MehmetEralpKose/Ripple-Warriors-Hardware-Project-/3phase_diode+buck/Test Results/R load/optocoupler voltage.jpeg

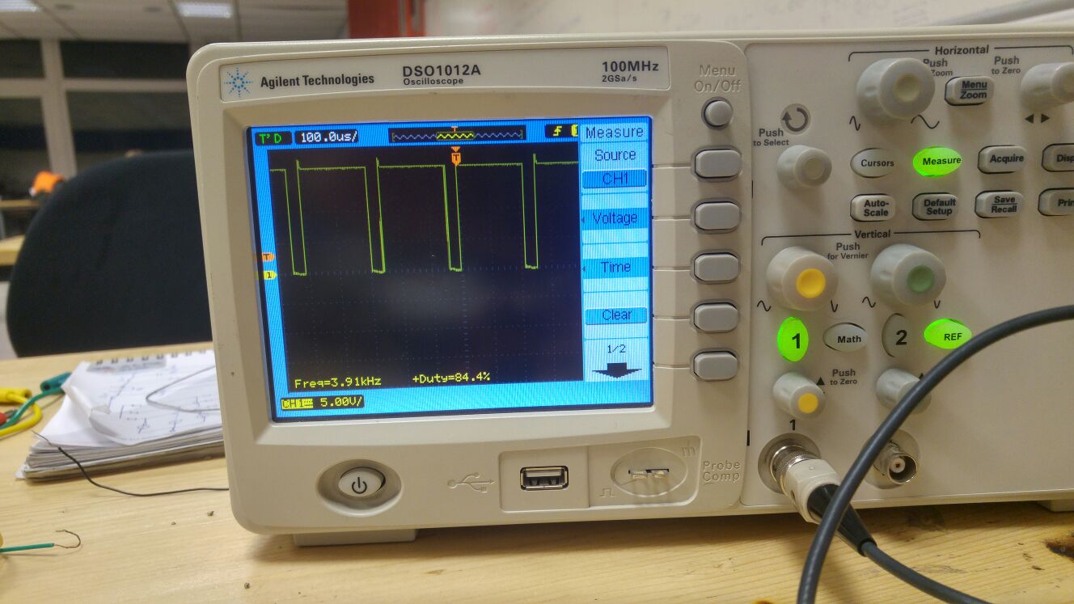
3phase_diode+buck/Test Results/R load/optocoupler voltage.jpeg
