MehmetEralpKose/Ripple-Warriors-Hardware-Project-/3phase_diode+buck/Test Results/Motor/Output current and voltage for motor load.jpeg

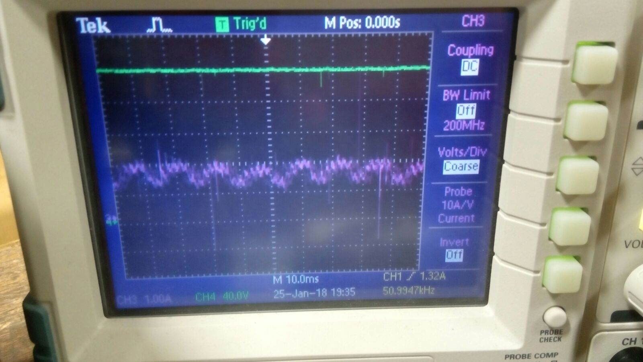
3phase_diode+buck/Test Results/Motor/Output current and voltage for motor load.jpeg
