MehmetEralpKose/Ripple-Warriors-Hardware-Project-/README.md

# Ripple-Warriors-Hardware-Project-

This repository presents Hardware Project of EE463 Static Power Conversion-I. 
Team Members:
[Raşit Gökmen](https://github.com/rasitgokmen)
[Mehmet Eralp Köse](https://github.com/MehmetEralpKose)
[Mahmut Enes Kara](https://github.com/mahmuteneskara)
