MehmetEralpKose/Ripple-Warriors-Hardware-Project-/3phase_diode+buck/overall schematic.png

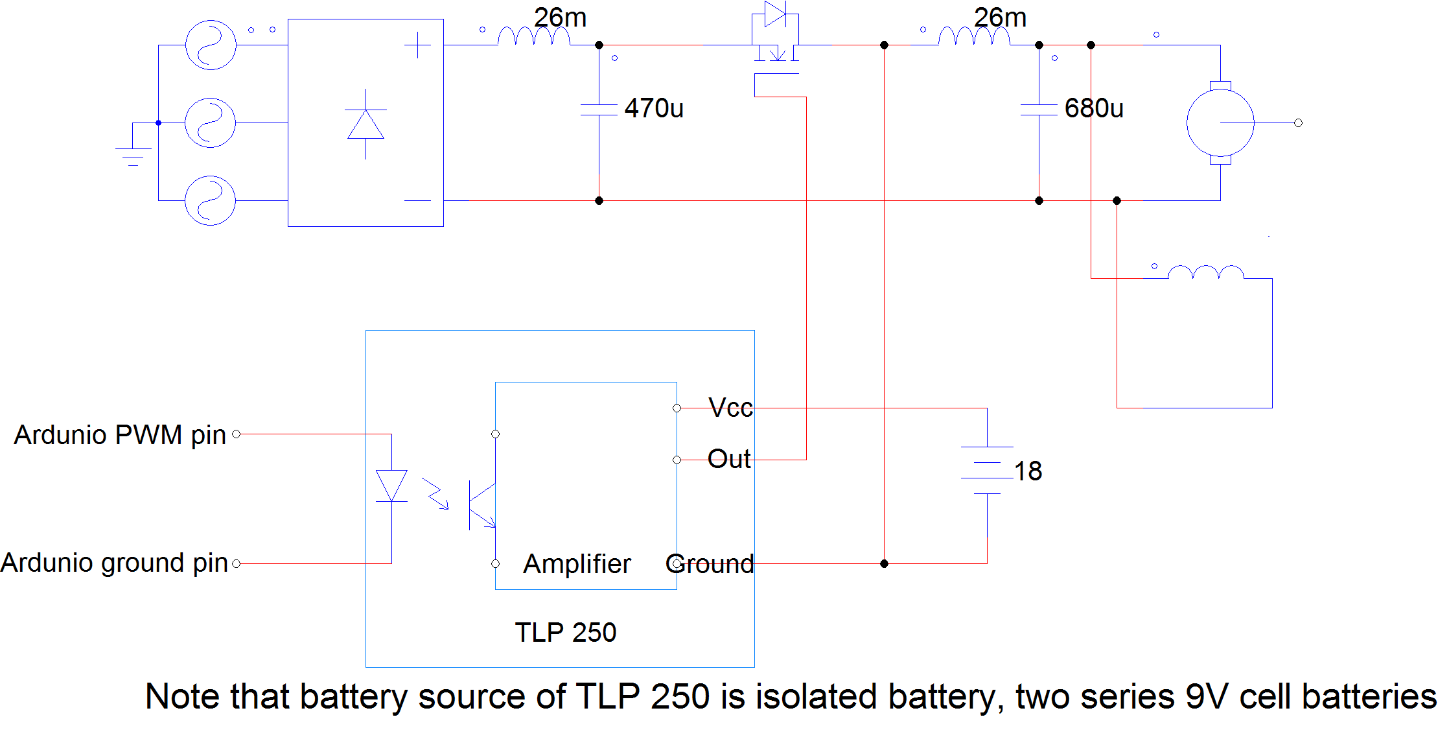
3phase_diode+buck/overall schematic.png
