MehmetEralpKose/Ripple-Warriors-Hardware-Project-/Researches/Block_Diagram of Hardware Project.PNG

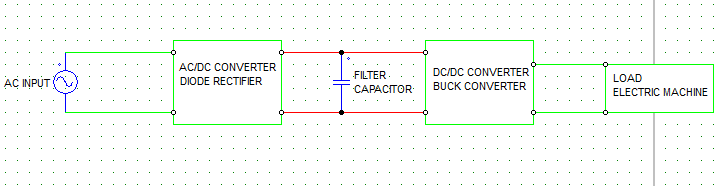
Researches/Block_Diagram of Hardware Project.PNG
