MehmetEralpKose/Ripple-Warriors-Hardware-Project-/Researches/Circuit_Schematic.JPG

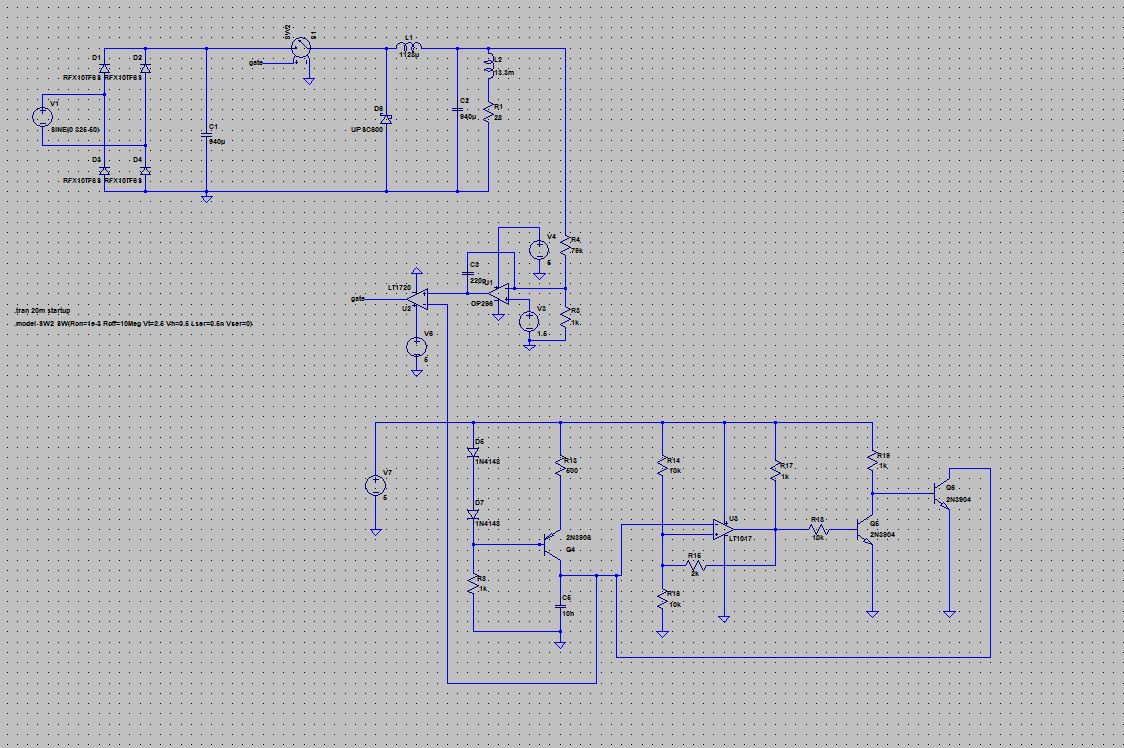
Researches/Circuit_Schematic.JPG
