MehmetEralpKose/Ripple-Warriors-Hardware-Project-/Researches/Rectifier_outputcurrent and voltage.PNG

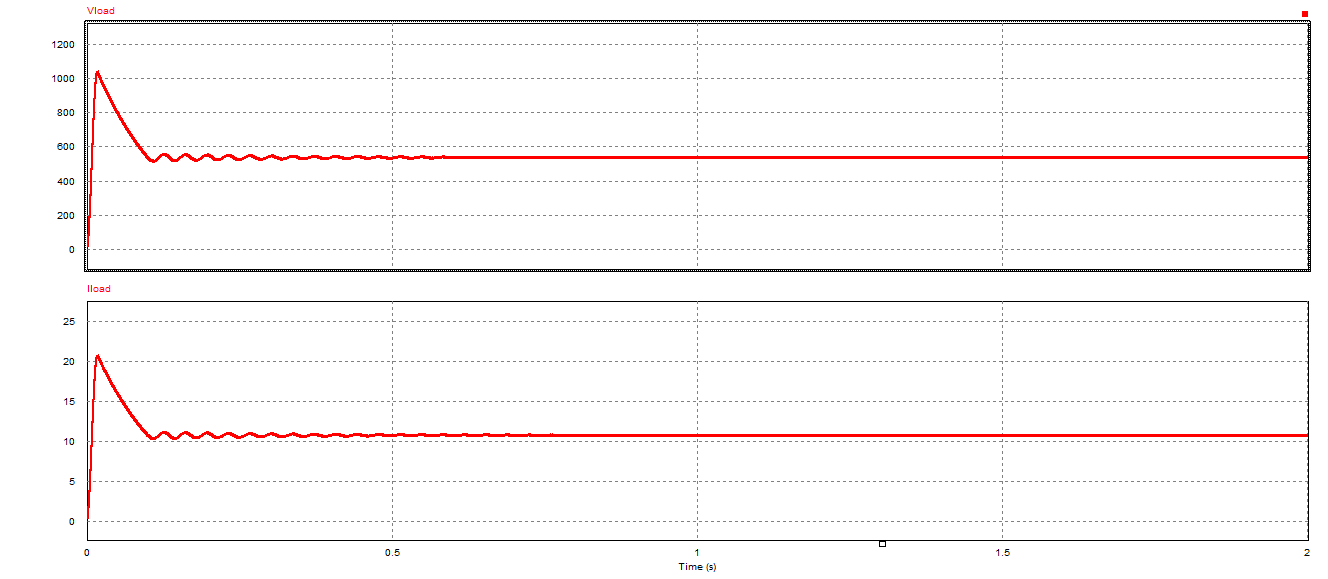
Researches/Rectifier_outputcurrent and voltage.PNG
