MehmetEralpKose/Ripple-Warriors-Hardware-Project-/Researches/Vout.png

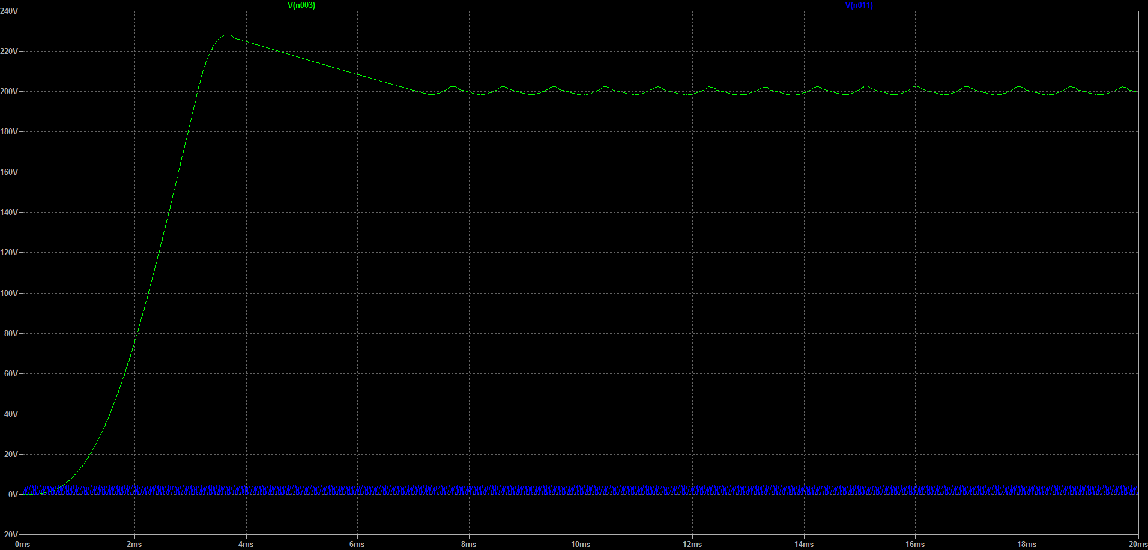
Researches/Vout.png
