MehmetEralpKose/Ripple-Warriors-Hardware-Project-/3phase_diode+buck/Test Results/Motor/Inductor voltage for motor.jpeg

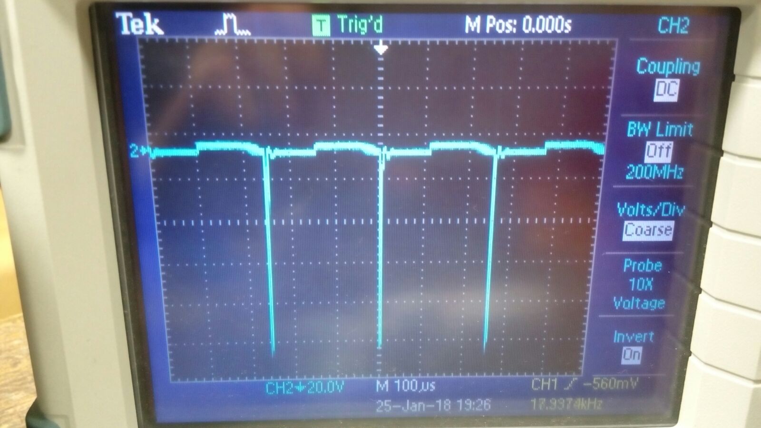
3phase_diode+buck/Test Results/Motor/Inductor voltage for motor.jpeg
