MehmetEralpKose/Ripple-Warriors-Hardware-Project-/3phase_diode+buck/Test Results/Motor/Input current for motor.jpeg

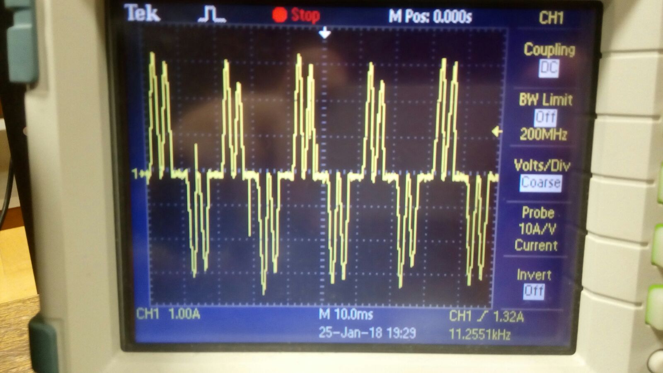
3phase_diode+buck/Test Results/Motor/Input current for motor.jpeg
