MehmetEralpKose/Ripple-Warriors-Hardware-Project-/3phase_diode+buck/Test Results/Motor/Output current for motor.jpeg

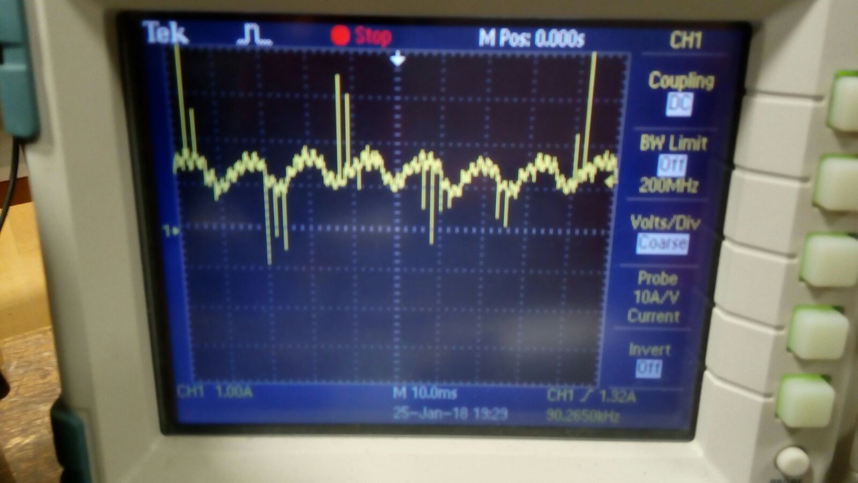
3phase_diode+buck/Test Results/Motor/Output current for motor.jpeg
