MehmetEralpKose/Ripple-Warriors-Hardware-Project-/3phase_diode+buck/Test Results/Motor/Output power.jpeg

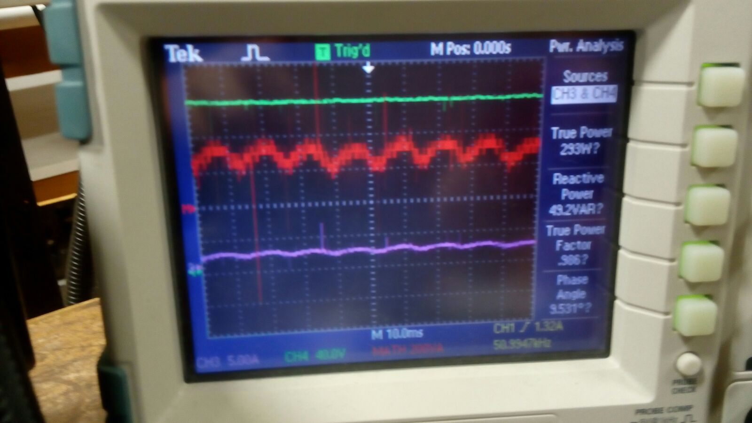
3phase_diode+buck/Test Results/Motor/Output power.jpeg
