MehmetEralpKose/Ripple-Warriors-Hardware-Project-/3phase_diode+buck/Test Results/Motor/Output voltage and PWM for motor.jpeg

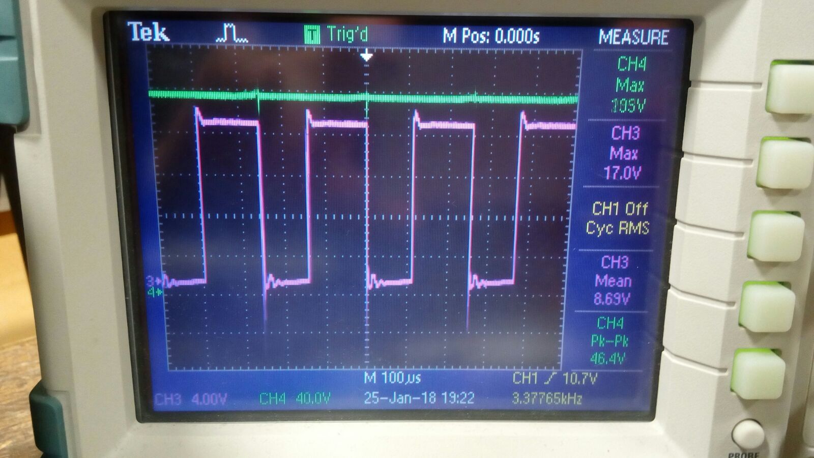
3phase_diode+buck/Test Results/Motor/Output voltage and PWM for motor.jpeg
