MehmetEralpKose/Ripple-Warriors-Hardware-Project-/3phase_diode+buck/Test Results/Motor/Temperature of the power MOSFET under load after 5 minutes.jpeg

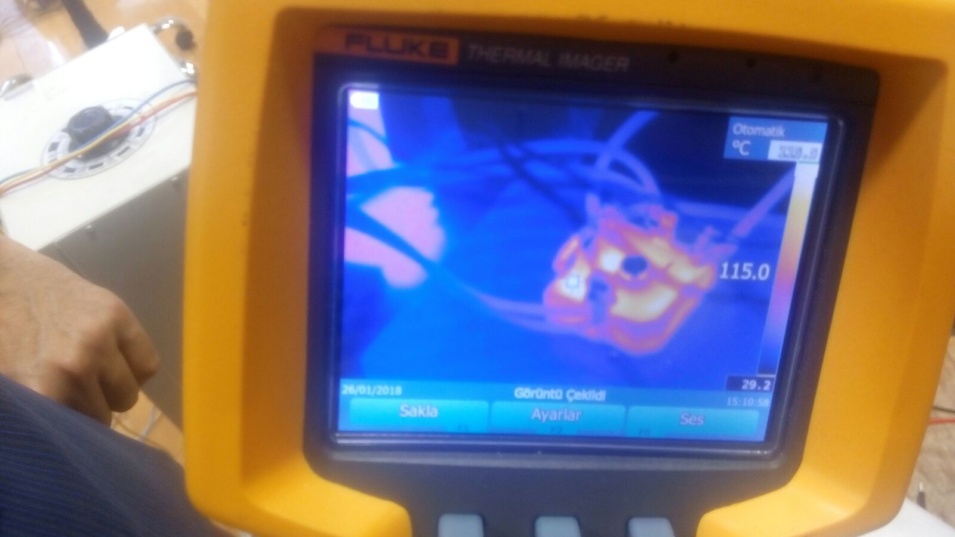
3phase_diode+buck/Test Results/Motor/Temperature of the power MOSFET under load after 5 minutes.jpeg
