MehmetEralpKose/Ripple-Warriors-Hardware-Project-/3phase_diode+buck/Test Results/R load/Duty cycle and output current- voltages for R load .jpeg

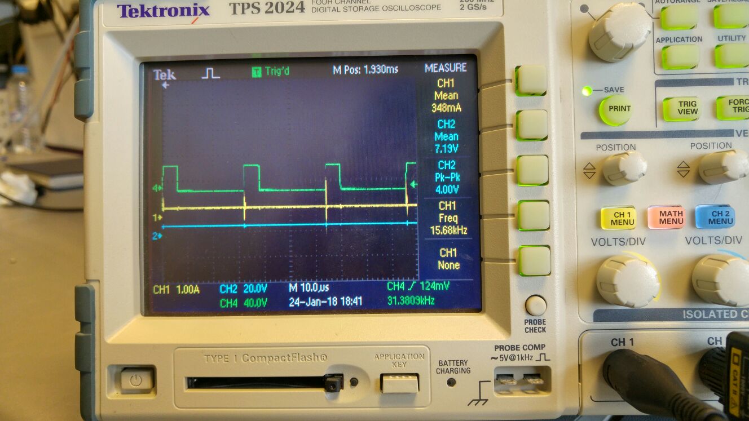
3phase_diode+buck/Test Results/R load/Duty cycle and output current- voltages for R load .jpeg
