MehmetEralpKose/Ripple-Warriors-Hardware-Project-/3phase_diode+buck/Test Results/R load/Inductor voltage for 4kHz.jpeg

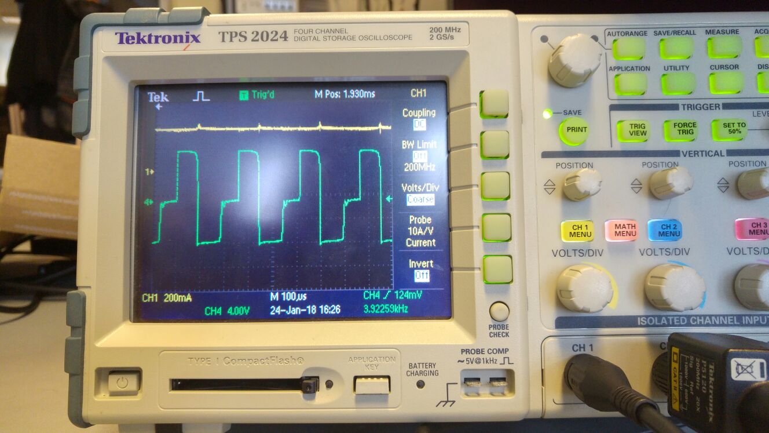
3phase_diode+buck/Test Results/R load/Inductor voltage for 4kHz.jpeg
