MehmetEralpKose/Ripple-Warriors-Hardware-Project-/3phase_diode+buck/Test Results/R load/Input current for R load.jpeg

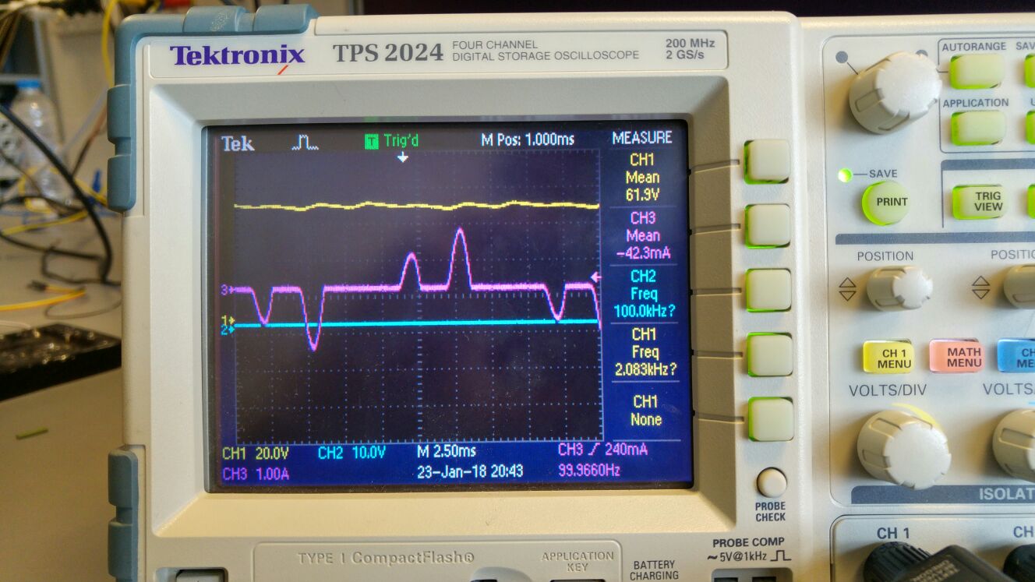
3phase_diode+buck/Test Results/R load/Input current for R load.jpeg
