MehmetEralpKose/Ripple-Warriors-Hardware-Project-/3phase_diode+buck/Test Results/R load/Optocoupler Rise and Fall time.jpeg

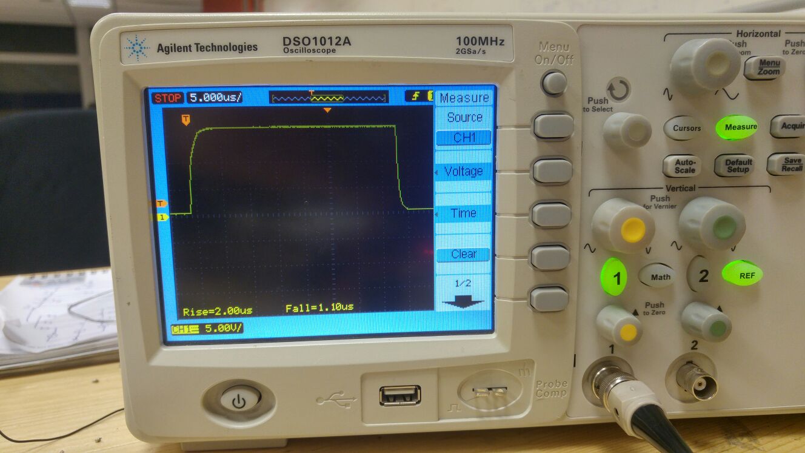
3phase_diode+buck/Test Results/R load/Optocoupler Rise and Fall time.jpeg
