MehmetEralpKose/Ripple-Warriors-Hardware-Project-/3phase_diode+buck/Test Results/R load/Output of optocoupler voltage, output voltage and current.jpeg

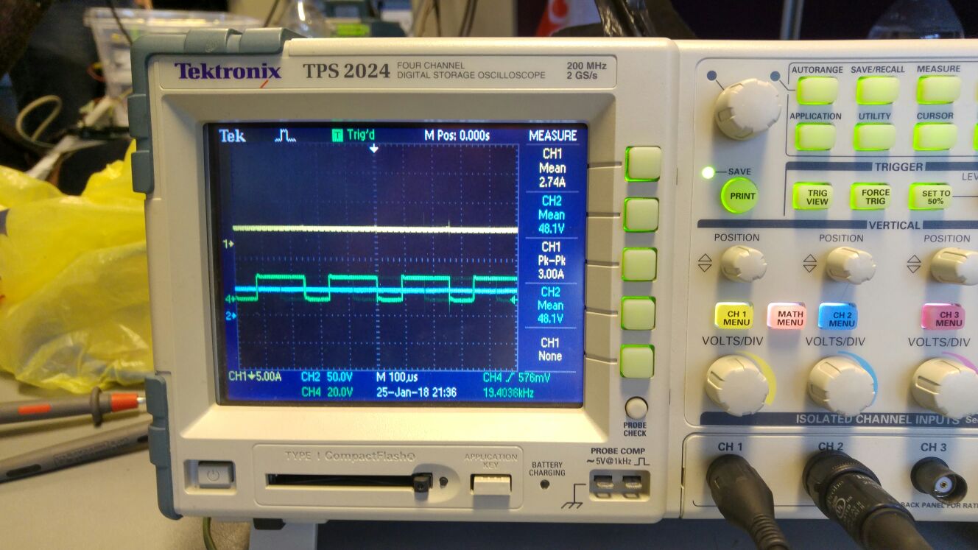
3phase_diode+buck/Test Results/R load/Output of optocoupler voltage, output voltage and current.jpeg
