MehmetEralpKose/Ripple-Warriors-Hardware-Project-/3phase_diode+buck/Test Results/R load/Output of Three phase Diode rectifier.jpeg

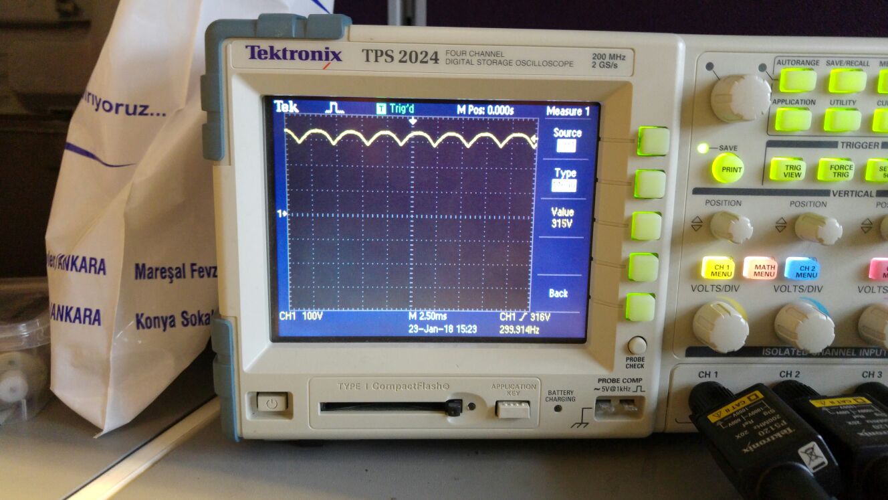
3phase_diode+buck/Test Results/R load/Output of Three phase Diode rectifier.jpeg
