MehmetEralpKose/Ripple-Warriors-Hardware-Project-/3phase_diode+buck/Test Results/R load/R load THD.jpeg

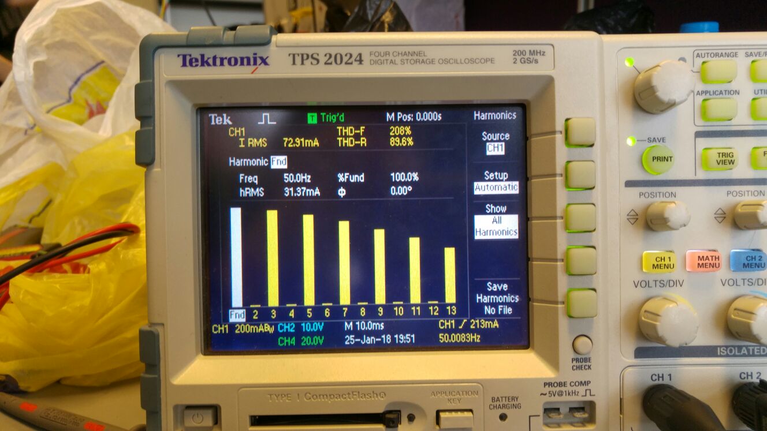
3phase_diode+buck/Test Results/R load/R load THD.jpeg
