MehmetEralpKose/Ripple-Warriors-Hardware-Project-/(commit log)

2018-01-12 Gate Driver,very low propogation delay and high-side drive
2018-01-16 Buck converter application note
    For components values calculation
2018-01-25 Simulation Schematics
2018-01-26 R load and motor simulations
2018-01-27 PWM code is added
